freetronics/OLEDSTICK/OLEDStick.pdf

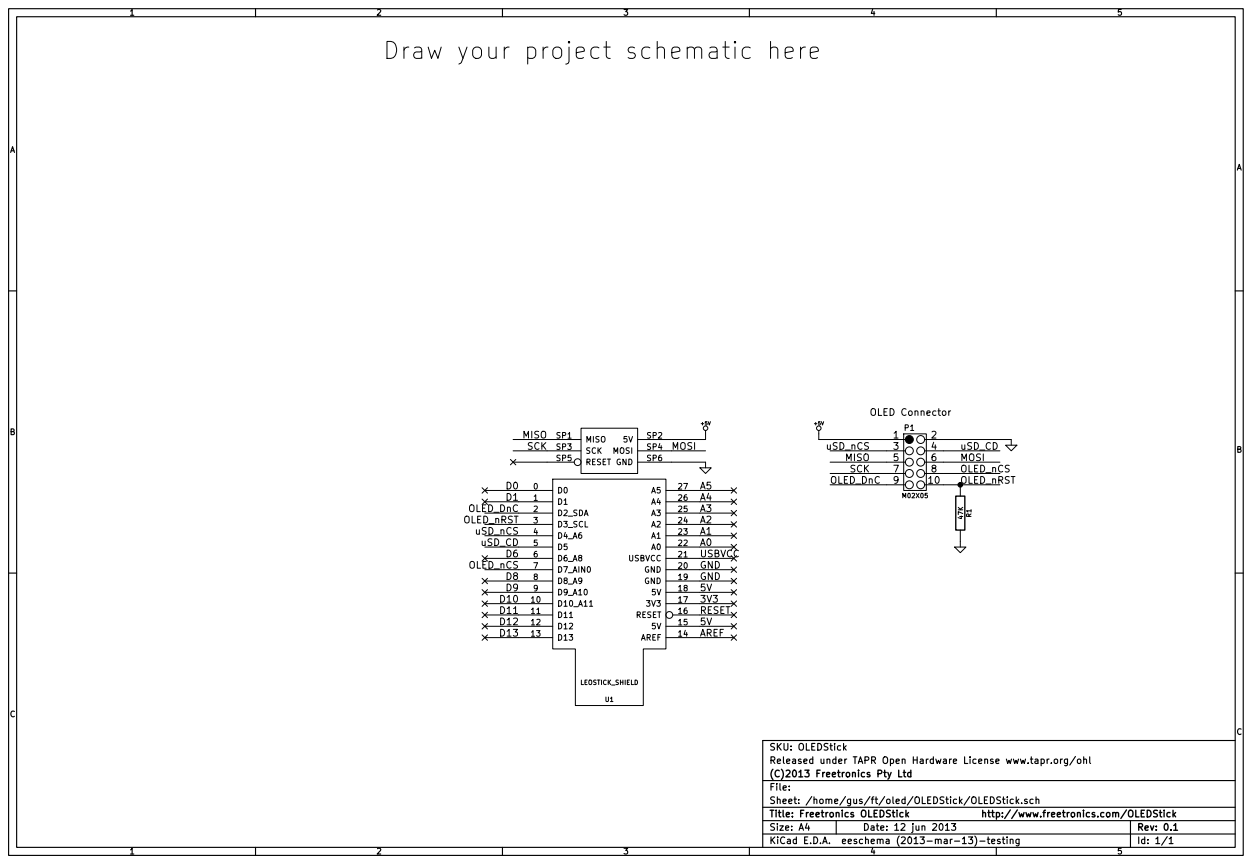
[picture p1: page 1]

+5V Draw your project schematic here

C SKU: OLEDStick Released under TAPR Open Hardware License www.tapr.org/ohl
