freetronics/OLEDSTICK/OLED128LeoStick.sch

## KiCad design OLED128LeoStick.sch (2013-05-23)

Schematic: OLED128LeoStick.sch

Parts:
P1: CONN_10
U1: LEOSTICK_SHIELD

Notes on the sheet:
OLED128 Connector
