freetronics/OLEDSTICK/(commit log)

2013-05-23 First iteration completed
    [OLED128LeoStick.kicad_pcb, OLED128LeoStick.sch]
2013-05-23 Use proper SKU/name, OLEDSTICK, add URL to board design
    [OLEDStick.kicad_pcb, OLEDStick.sch]
2013-05-23 Add a PDF and a 'you can draw your schematic' note
    [OLEDStick.sch]
2013-05-27 Change connector schematic symbol to 2x5 not 1x10
    [OLEDStick.kicad_pcb, OLEDStick.sch]
2013-06-12 Finish off silkscreen, fatten power traces
    [OLEDStick.kicad_pcb, OLEDStick.sch]
2013-06-21 Increase trace widths
    [OLEDStick.kicad_pcb]
2013-06-23 Increase small throughhole pad size a bit, optimise drill sizes
    [OLEDStick.kicad_pcb]
2013-06-23 Silkscreen touchup
    [OLEDStick.kicad_pcb]
2013-07-24 Add 47K pulldown resistor on Reset, to hold OLED module in reset while LeoStick resets
    [OLEDStick.kicad_pcb, OLEDStick.sch]
2013-08-08 Bump revison to 0.2
    [OLEDStick.kicad_pcb]
2013-09-18 V0.3 Update: Enlarge silkscreen text where possible, enlarge prototyping holes and pull back solder mask
    [OLEDStick.kicad_pcb]
