freetronics/OLEDSTICK/(notices)

Notices in the files:
OLED128LeoStick.sch:
(C)2013 Freetronics Pty Ltd
